Tahyel27/WaveSynthDIY/playground/button_registers/button_registers.kicad_sch

## KiCad design playground/button_registers/button_registers.kicad_sch (2025-11-22)

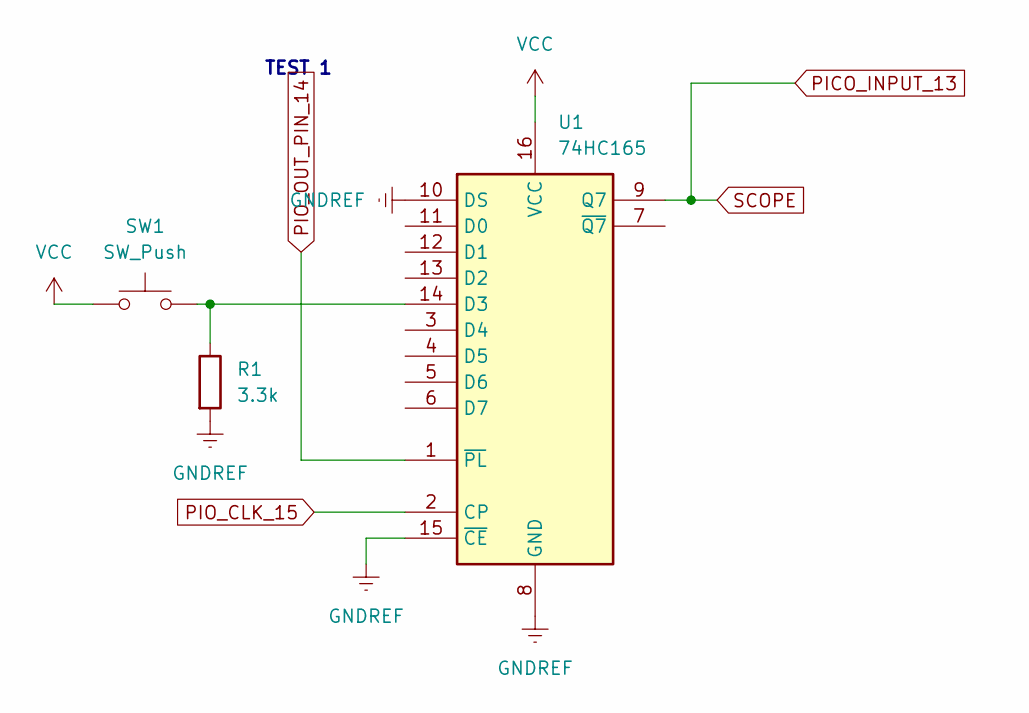
[picture p2: schematic button_registers.kicad_sch]

Parts:
R1: 3.3k
SW1: SW_Push
U1: 74HC165

Connections:
GNDREF: R1.2, U1.8 (GND), U1.10 (DS), U1.15 (~CE)
unnamed: R1.1, SW1.2, U1.14 (D3)
PICO_INPUT_13: U1.9 (Q7)
PIO_CLK_15: U1.2 (CP)
PIO_OUT_PIN_14: U1.1 (~PL)
VCC: SW1.1, U1.16 (VCC)

Notes on the sheet:
TEST 1
