Tahyel27/WaveSynthDIY/(commit log)

2025-11-18 Fixed bug in stereo output, changed channel mode name to chmod and added SPS to channel info
    [main.cpp]
2025-11-19 Added more device info and added better example of direct write mode
2025-11-20 Added button registers project
    [button_registers.kicad_pcb, button_registers.kicad_sch]
2025-11-20 fixed gitignore for button registers
2025-11-20 created assembly for first test
2025-11-20 Set up correct output for performing test 1
    [button_registers.kicad_sch]
2025-11-20 Added ground to serial in pin, test passed succesfully
    [button_registers.kicad_sch]
2025-11-21 Added input to PIO assembly
2025-11-21 test 2 schematic
    [button_registers.kicad_sch]
2025-11-21 Added simple button decode and increased frequency
2025-11-21 Added FIFO benchmarks and noticed bug related to stalling
2025-11-21 Testing new configuration for reading 32 buttons
2025-11-21 Now reading 32 pins, figured out shift direction, so closest (pin H) is MSB
2025-11-21 added ButtonArray files
2025-11-21 Added PIO functionality to ButtonArray class
2025-11-21 Completed first version of ButtonArray class that can read up to 32 buttons
2025-11-22 Added important ground connection to CLK INH
    [button_registers.kicad_sch]
2025-11-23 Working on analog MUX, correctly outputting bits
    [analog_mux.kicad_pcb, analog_mux.kicad_sch]
2025-11-23 Analog read from pin 26
2025-11-23 AnalogArray library working correctly
    [AnalogArray.cpp, AnalogArray.hpp]
2025-11-25 Removed dobule buffer mode and global sample callback
2025-11-27 Separetad audio interface classes into their own header file, that is not dependent on pico-skd
2025-11-27 fixed type bug in interface
    [AudioInterface.hpp]
2025-11-27 fixed bug in mock synth
    [WavetableSynth.hpp]
2025-11-29 table generator prints the first value of the table at the end, to preven jumping during interpolation
2025-11-29 fixed fm modulation bugs
    [WavetableSynth.cpp, WavetableSynth.hpp]
2025-12-07 added state variable filter and external voice loading
2025-12-11 implemented equal power mixing for voices
2025-12-13 temporary filter optimization
2025-12-18 added testing ground for shift register based encoder driver
2025-12-19 encoder support
2026-07-17 cleaned up sideset pin setup
2026-07-17 Added DMA handler
2026-07-17 Removed modes from audio device, all that can be done by the AudioBuffer struct already
2026-07-22 implemented low pass filter opcode
2026-07-22 added short buffer math operations and test patch to main.cpp
    [main.cpp]
2026-07-22 fixed potential perf issue in sv filter, g and d are now calculated by linear interpolation
2026-08-26 added missing pragma once
    [EffectStack.hpp]
2026-08-31 made project buildeable, so far audio is not working
    [ButtonArray.cpp, Events.hpp, InstrumentManager.hpp, main.cpp]
2026-08-31 fixed main testing loop
    [main.cpp]
2026-09-01 simplified the unnecessarily complicated polling in ButtonArray and EncoderArray
2026-09-01 refactored ButtonArray and simplified button state management
2026-09-01 made ButtonArray use global event queue
2026-09-01 refactored EncoderArray in the same manner as ButtonArray
2026-09-09 fixed bug in note tracking not returning -1
    [AudioStack.hpp]
2026-09-10 tested the pio encoder example
2026-09-10 set up Encoder, not working yet
    [Encoder.hpp, main.cpp]
2026-09-10 single encoder now tested and working, analog array removed from main
2026-09-11 added encoder ID system, tested two encoders on same pio
2026-09-15 tested midi uart and midi state machine
2026-09-16 tested SPI master out with shift register
2026-09-16 Implemented ButtonMatrix
2026-09-24 added schematic for the current configuration
    [pico_synth.kicad_pcb, pico_synth.kicad_sch]
2026-09-24 fixed DIN connector symbol
    [pico_synth.kicad_sch]
2026-09-25 created UI, added rotary encoder mapping, succesfully tested on hardware
2026-09-25 added midi parsing and simple functionality setting using buttons
2026-09-25 saner encoder starting positions
2026-09-28 fixed shift register in schematic
2026-09-28 added a way to set the external register from an encoder knob at init
2026-09-28 ext register initialized with encoder data at ui startup
2026-09-28 added additional encoders
2026-09-28 updated patch to use encoders
2026-09-30 added pull up resistor at UART RX pin to suppress spurious uart messages
2026-09-30 updated main for current config
2026-10-10 fifth encoder tested
2026-10-10 added chip select to spi matric controller, so now it can be used with 74hc595
